jflorchi/micro_pedal/board/board.jpg

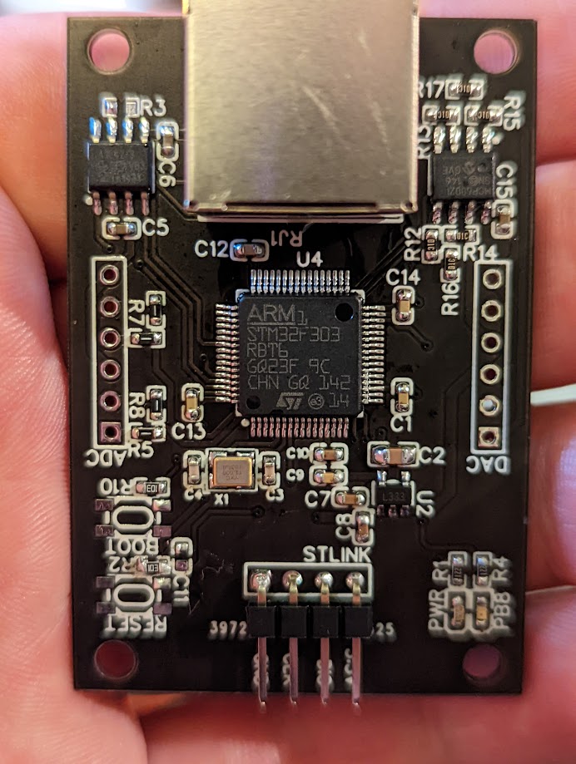
board/board.jpg
