jflorchi/micro_pedal/board/micro_pedal_gerb.png

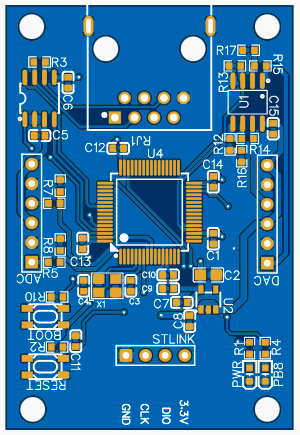
board/micro_pedal_gerb.png
