jflorchi/micro_pedal/board/BOM_PCB_micro_pedal_3_2022-07-07.csv

ID | Name | Designator | Footprint | Quantity | Manufacturer Part | Manufacturer | Supplier | Supplier Part | Price | Pins | 3DModel | JLCPCB Part Class | Contributor | Resistance | Resistance (Ohms) | Voltage - Supply | link
1 | HDR-F-2.54_1x6 | ADC,DAC | HDR-F-2.54_1X6 | 2 |  |  | LCSC | C40877 | 0.07 | 6 | HDR-F-2.54_1x6 |  | LCEDA_Lib
2 | TS-1145A-B-A | BOOT,RESET | SW-SMD_4P-L4.2-W3.2-P2.15-LS5.2 | 2 | TS-1145A-B-A | XKB Enterprise | LCSC | C318904 | 0.053 | 4 | SW-SMD_4P-L4.2-W3.2-P2.15-LS5.2 | Extended Part | LCSC |  |  |  | https://item.szlcsc.com/617092.html
3 | 100nF | C1,C11,C12,C13,C14 | C0603 | 5 | CL10B104KB8NNNC | SAMSUNG | LCSC | C1591 | 0.001 | 2 | C0603_L1.6-W0.8-H0.8 | Extended Part | lcsc |  |  |  | https://item.szlcsc.com/362304.html
4 | 8pF | C3,C4 | C0603 | 2 | 0603CG8R0C500NT | FH | LCSC | C36508 | 0.003 | 2 | C0603_L1.6-W0.8-H0.8 | Extended Part | lcsc |  |  |  | https://item.szlcsc.com/362304.html
5 | 10nF | C9 | C0603 | 1 | CL10B103KB8NNNC | SAMSUNG | LCSC | C1589 | 0.001 | 2 | C0603_L1.6-W0.8-H0.8 | Extended Part | lcsc |  |  |  | https://item.szlcsc.com/362304.html
6 | 1uF | C10,C8 | C0603 | 2 | CS1608X7R105K250NRB | Samwha Capacitor | LCSC | C513775 | 0.007 | 2 | C0603_L1.6-W0.8-H0.8 | Extended Part | LCSC |  |  |  | https://item.szlcsc.com/362304.html
7 | 4.7uF | C2 | C0805 | 1 | CS2012X5R475K500NRE | Samwha Capacitor | LCSC | C513770 | 0.025 | 2 | C0805_L2.0-W1.3-H1.3 |  | LCSC |  |  |  | https://item.szlcsc.com/373011.html
8 | 100nF | C5,C6,C15 | C0603 | 3 | CS1608X7R104K500NRB | SAMWHA(三和) | LCSC | C2909627 | 0.003 | 2 | C0603_L1.6-W0.8-H0.8 | Extended Part | LCSC |  |  |  | https://item.szlcsc.com/362304.html
9 | TJA1042T/3/1J | CAN_TRANS1 | SOIC-8_L5.0-W4.0-P1.27-LS6.0-BL | 1 | TJA1042T/3/1J | NXP Semicon | LCSC | C132227 | 1.174 | 8 | SOIC-8_L4.9-W3.9-H1.7-LS6.0-P1.27 | Extended Part | LCSC |  |  |  | https://item.szlcsc.com/417287.html
10 | 19-217/R6C-AL1M2VY/3T | PB8,PWR | LED0603-R-RD | 2 | 19-217/R6C-AL1M2VY/3T | EVERLIGHT | LCSC | C72044 | 0.015 | 2 | LED0603_L1.6-W0.8-H0.6 | Extended Part | lcsc |  |  |  | https://lcsc.com/product-detail/Light-Emitting-Diodes-LED_Hubei-KENTO-Elec-0603-Green_C12624.html
11 | 220Ω | R1,R4 | R0603 | 2 | 0603WAJ0221T5E | UniOhm | LCSC | C1226 | 0.001 | 2 | R0603_L1.6-W0.8-H0.8 | Extended Part | lcsc |  | 220 |  | https://www.mouser.in/datasheet/2/447/PYu_RT_1_to_0_01_RoHS_L_11-1669912.pdf
12 | 10K | R2,R10 | R0603 | 2 | RC0603JR-0710KL | YAGEO | LCSC | C99198 | 0.001 | 2 | R0603_L1.6-W0.8-H0.8 | Extended Part | lcsc | 10kΩ |  |  | https://www.mouser.in/datasheet/2/447/PYu_RT_1_to_0_01_RoHS_L_11-1669912.pdf
13 | 120Ω | R3 | R0603 | 1 | ERA3AEB121V | PANASONIC | LCSC | C491112 | 0.082 | 2 | R0603_L1.6-W0.8-H0.8 | Extended Part | LCSC |  |  |  | https://www.mouser.in/datasheet/2/447/PYu_RT_1_to_0_01_RoHS_L_11-1669912.pdf
14 | KH-RJ45-58-8P8C | RJ1 | RJ45-TH_KH-RJ45-58-8P8C | 1 | KH-RJ45-58-8P8C | kinghelm(金航标) | LCSC | C2683360 | 0.274 | 10 | RJ45-TH_KH-RJ45-58-8P8C | Extended Part | LCSC |  |  |  | https://atta.szlcsc.com/upload/public/pdf/source/20210106/C2683360_ED9F3988DA748C26BF57E22522EFC041.pdf
15 | MCP6002T-I/SN | U1 | SOIC-8_L4.9-W3.9-P1.27-LS6.0-BL | 1 | MCP6002T-I/SN | MICROCHIP | LCSC | C7377 | 0.31 | 8 | SOIC-8_L4.9-W3.9-H1.7-LS6.0-P1.27 | Basic Part | lcsc |  |  |  | https://so.szlcsc.com/global.html?c=&k=C9843
16 | TPMIC5233-3.3YM5 | U2 | SOT-23-5_L3.0-W1.7-P0.95-LS2.8-BR | 1 | TPMIC5233-3.3YM5 | TECH PUBLIC(台舟) | LCSC | C2937037 | 0.285 | 5 | SOT-23-5_L2.9-W1.6-H1.1-LS2.8-P0.95 |  | LCSC |  |  |  | https://item.szlcsc.com/236104.html
17 | STM32F303RBT6 | U4 | LQFP-64_L10.0-W10.0-P0.50-LS12.0-BL | 1 | STM32F303RBT6 | STMicroelectronics | LCSC | C130453 | 4.549 | 64 | LQFP-64_L10.0-W10.0-H1.4-LS12.0-P0.50 | Extended Part | LCSC |  |  | 2V ~ 3.6V | https://item.szlcsc.com/92458.html
18 | 12MHz 9pF | X1 | OSC-SMD_4P-L3.2-W2.5-BL | 1 | X322512MLB4SI | YXC | LCSC | C112971 | 0.088 | 4 | OSC-SMD_4P-L3.2-W2.5-H1.0 | Extended Part | lcsc |  |  |  | https://item.szlcsc.com/15866.html
19 | HDR-F-2.54_1x4 | STLINK | HDR-F-2.54_1X4 | 1 |  |  | LCSC | C225501 | 0.083 | 4 | HDR-F-2.54_1x4 |  | LCEDA_Lib
20 | 2.2uF | C7 | C0603 | 1 | CS1608X7R225K100NRB | Samwha Capacitor | LCSC | C516003 | 0.012 | 2 | C0603_L1.6-W0.8-H0.8 | Extended Part | LCSC |  |  |  | https://item.szlcsc.com/362304.html
21 | 1kΩ | R5,R6,R7,R8 | R0603 | 4 | ERJ-PB3B1001V | PANASONIC | LCSC | C193680 | 0.05 | 2 | R0603_L1.6-W0.8-H0.8 | Extended Part | LCSC |  | 1K |  | https://www.mouser.in/datasheet/2/447/PYu_RT_1_to_0_01_RoHS_L_11-1669912.pdf
22 | 10kΩ | R12,R13,R14,R15,R16,R17 | R0603 | 6 | ARG03BTC1002 | Viking Tech | LCSC | C309083 | 0.022 | 2 | R0603_L1.6-W0.8-H0.8 | Extended Part | LCSC |  | 10K |  | https://www.mouser.in/datasheet/2/447/PYu_RT_1_to_0_01_RoHS_L_11-1669912.pdf
