jflorchi/micro_pedal/board/schematic.pdf

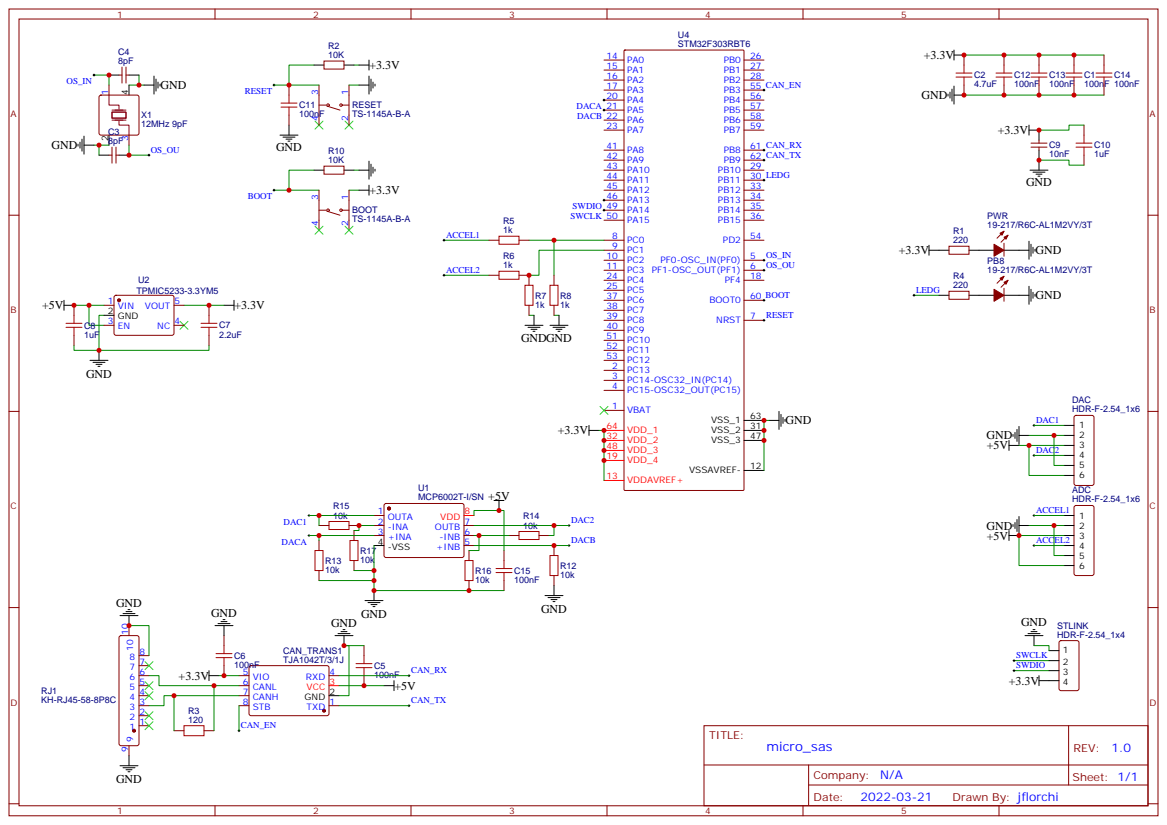
[picture p3: page 1]
