jflorchi/micro_pedal/firmware/Core/Src/main.c

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
/* Includes ------------------------------------------------------------------*/
#include "main.h"

/* USER CODE BEGIN Includes */
#include "can_definitions.h"
#include "crc.h"

/* USER CODE END Includes */

/* USER CODE BEGIN PTD */
#define ENABLE_CAN_TRANSCEIVER() HAL_GPIO_WritePin(GPIOB, GPIO_PIN_3, GPIO_PIN_RESET)
#define LED_OFF() HAL_GPIO_WritePin(GPIOB, GPIO_PIN_11, GPIO_PIN_RESET)
#define LED_ON() HAL_GPIO_WritePin(GPIOB, GPIO_PIN_11, GPIO_PIN_SET)
#define MAX(x, y) ((x > y) ? (x) : (y))
#define ABS(x) ((x) > 0 ? (x) : -(x))
/* USER CODE END PTD */

 ADC_HandleTypeDef hadc1;
ADC_HandleTypeDef hadc2;

CAN_HandleTypeDef hcan;

DAC_HandleTypeDef hdac;

/* USER CODE BEGIN PV */
CAN_TxHeaderTypeDef txHeader;
uint32_t  txMailbox;
CAN_FilterTypeDef canfil;
/* USER CODE END PV */

void SystemClock_Config(void);
static void MX_GPIO_Init(void);
static void MX_ADC1_Init(void);
static void MX_ADC2_Init(void);
static void MX_CAN_Init(void);
static void MX_DAC_Init(void);
/* USER CODE BEGIN PFP */
//void HAL_CAN_RxFifo0MsgPendingCallback(CAN_HandleTypeDef *hcan);
//void HAL_CAN_RxFifo1MsgPendingCallback(CAN_HandleTypeDef *hcan);
void readCAN();
void CAN_RX_Interrupt(CAN_HandleTypeDef *hcan, int mailbox);
uint32_t sendCAN(uint16_t id, uint8_t buffer[], uint8_t len);
//void HAL_TIM_PeriodElapsedCallback(TIM_HandleTypeDef *htim);
/* USER CODE END PFP */

/* USER CODE BEGIN 0 */

#define CAN_GAS_INPUT  0x200
#define CAN_GAS_OUTPUT 0x201U
#define CAN_GAS_SIZE 6
#define COUNTER_CYCLE 0xFU

// two independent values
uint16_t gas_set_0 = 0;
uint16_t gas_set_1 = 0;

#define MAX_TIMEOUT 1000U
uint32_t timeout = 0;
uint32_t current_index = 0;

#define NO_FAULT 0U
#define FAULT_BAD_CHECKSUM 1U
#define FAULT_SEND 2U
#define FAULT_SCE 3U
#define FAULT_STARTUP 4U
#define FAULT_TIMEOUT 5U
#define FAULT_INVALID 6U
uint8_t state = FAULT_STARTUP;
const uint8_t crc_poly = 0xD5U;  // standard crc8

uint32_t pdl0 = 0;
uint32_t pdl1 = 0;
unsigned int pkt_idx = 0;

int last_tick = 0;


/* USER CODE END 0 */

/**
  * @brief  The application entry point.
  * @retval int
  */
int main(void)
{
  /* MCU Configuration--------------------------------------------------------*/

  /* Reset of all peripherals, Initializes the Flash interface and the Systick. */
  HAL_Init();

  /* Configure the system clock */
  SystemClock_Config();

  /* Initialize all configured peripherals */
  MX_GPIO_Init();
  MX_ADC1_Init();
  MX_ADC2_Init();
  MX_CAN_Init();
  MX_DAC_Init();
  /* USER CODE BEGIN 2 */
  ENABLE_CAN_TRANSCEIVER();
  LED_OFF();
  if (HAL_CAN_Start(&hcan) != HAL_OK) {
	  LED_ON();
  }
  HAL_CAN_ActivateNotification(&hcan, CAN_IT_RX_FIFO0_MSG_PENDING);
  HAL_CAN_ActivateNotification(&hcan, CAN_IT_RX_FIFO1_MSG_PENDING);

  /* USER CODE END 2 */

  /* Infinite loop */
  /* USER CODE BEGIN WHILE */
  while (1) {
	  readCAN();
	  int tick = HAL_GetTick();
	  if (timeout == MAX_TIMEOUT) {
	    state = FAULT_TIMEOUT;
	  } else {
	    timeout += 1U;
	  }

	  if (tick - last_tick >= 20) {
		  uint8_t dat[6];
		  dat[0] = (pdl0 >> 8) & 0xFFU;
		  dat[1] = (pdl0 >> 0) & 0xFFU;
		  dat[2] = (pdl1 >> 8) & 0xFFU;
		  dat[3] = (pdl1 >> 0) & 0xFFU;
		  dat[4] = ((state & 0xFU) << 4) | pkt_idx;
		  dat[5] = crc_checksum(dat, CAN_GAS_SIZE - 1, crc_poly);
		  sendCAN(CAN_GAS_OUTPUT, dat, 6);
		  ++pkt_idx;
		  pkt_idx &= COUNTER_CYCLE;
		  last_tick = tick;
	  }

	  HAL_ADC_Start(&hadc1);
	  HAL_ADC_PollForConversion(&hadc1, 1);
	  pdl0 = HAL_ADC_GetValue(&hadc1);

	  HAL_ADC_Start(&hadc2);
	  HAL_ADC_PollForConversion(&hadc2, 1);
	  pdl1 = HAL_ADC_GetValue(&hadc2);

	  // write the pedal to the DAC
	  if (state == NO_FAULT) {
		HAL_DAC_SetValue(&hdac, DAC_CHANNEL_1, DAC_ALIGN_12B_R, MAX(gas_set_0, pdl0));
		HAL_DAC_Start(&hdac, DAC_CHANNEL_1);
		HAL_DAC_SetValue(&hdac, DAC_CHANNEL_2, DAC_ALIGN_12B_R, MAX(gas_set_1, pdl1));
		HAL_DAC_Start(&hdac, DAC_CHANNEL_2);
	  } else {
		HAL_DAC_SetValue(&hdac, DAC_CHANNEL_1, DAC_ALIGN_12B_R, pdl0);
		HAL_DAC_Start(&hdac, DAC_CHANNEL_1);
		HAL_DAC_SetValue(&hdac, DAC_CHANNEL_2, DAC_ALIGN_12B_R, pdl1);
		HAL_DAC_Start(&hdac, DAC_CHANNEL_2);
	  }

    /* USER CODE END WHILE */

    /* USER CODE BEGIN 3 */
  }
  /* USER CODE END 3 */
}

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
/* USER CODE BEGIN 4 */


uint32_t sendCAN(uint16_t id, uint8_t buffer[], uint8_t len) {
	CAN_TxHeaderTypeDef header;

	header.IDE = CAN_ID_STD;
	header.RTR = CAN_RTR_DATA;
	header.TransmitGlobalTime = DISABLE;
	header.DLC = len;
	header.StdId = id;

	uint32_t mailbox;
	if (HAL_CAN_GetTxMailboxesFreeLevel(&hcan) > 0) {
		uint8_t res = HAL_CAN_AddTxMessage(&hcan, &header, buffer, &mailbox);
		if (res != HAL_OK) {
			state = FAULT_SEND;
		} else {
			state = NO_FAULT;
		}
	} else {
		if (HAL_CAN_IsTxMessagePending(&hcan, txMailbox)) {
			state = FAULT_SEND;
		}
	}

	return mailbox;
}

void CAN_RX_Interrupt(CAN_HandleTypeDef *hcan, int mailbox) {
	CAN_RxHeaderTypeDef tmp;
	uint8_t dat[8];
	HAL_CAN_GetRxMessage(hcan, mailbox, &tmp, dat);
	int address = tmp.StdId;
	if (address == CAN_GAS_INPUT) {
		uint16_t value_0 = (dat[0] << 8) | dat[1];
		uint16_t value_1 = (dat[2] << 8) | dat[3];
		uint8_t enable = ((dat[4] >> 7) & 1U) != 0U;
		uint8_t index = dat[4] & COUNTER_CYCLE;
		if (crc_checksum(dat, CAN_GAS_SIZE - 1, crc_poly) == dat[5]) {
			if (((current_index + 1U) & COUNTER_CYCLE) == index) {
				LED_ON();
				if (enable) {
					gas_set_0 = value_0;
					gas_set_1 = value_1;
				} else {
					// clear the fault state if values are 0
					if ((value_0 == 0U) && (value_1 == 0U)) {
						state = NO_FAULT;
					} else {
						state = FAULT_INVALID;
					}
					gas_set_0 = 0;
					gas_set_1 = 0;
				}
				timeout = 0;
			} else {
				LED_OFF();
			}
			current_index = index;
		} else {
			state = FAULT_BAD_CHECKSUM;
		}
	}
}

void readCAN() {
	if (HAL_CAN_GetRxFifoFillLevel(&hcan, CAN_RX_FIFO0) > 0) {
		CAN_RX_Interrupt(&hcan, CAN_RX_FIFO0);
	}
	if (HAL_CAN_GetRxFifoFillLevel(&hcan, CAN_RX_FIFO1) > 0) {
		CAN_RX_Interrupt(&hcan, CAN_RX_FIFO0);
	}
}

//void HAL_CAN_RxFifo0MsgPendingCallback(CAN_HandleTypeDef *hcan) {
//	CAN_RX_Interrupt(hcan, CAN_RX_FIFO0);
//}
//
//void HAL_CAN_RxFifo1MsgPendingCallback(CAN_HandleTypeDef *hcan) {
//	CAN_RX_Interrupt(hcan, CAN_RX_FIFO1);
//}

/* USER CODE END 4 */
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
