jflorchi/micro_pedal/firmware/micro_pedal.ioc

Mcu.UserName=STM32F303RBTx
PA13.Signal=SYS_JTMS-SWDIO
PA14.Signal=SYS_JTCK-SWCLK
PA4.Signal=COMP_DAC1_group
PA5.Signal=SharedAnalog_PA5
PB11.Signal=GPIO_Output
PB3.Signal=GPIO_Output
PB8.Signal=CAN_RX
PB9.Signal=CAN_TX
PC0.Signal=ADCx_IN6
PC1.Signal=ADCx_IN7
PF0-OSC_IN.Signal=RCC_OSC_IN
PF1-OSC_OUT.Signal=RCC_OSC_OUT
