jflorchi/micro_pedal/(commit log)

2022-07-07 add board
    [BOM_PCB_micro_pedal_3_2022-07-07.csv, PickAndPlace_PCB_micro_pedal_3_2022-07-07.csv]
2022-07-07 add board shot
2022-07-07 add picture of soldered board
